maximevlnt/CoolingBrick/Medias/ACDimmerModule.png

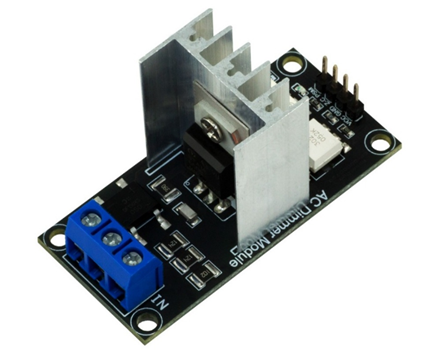
Medias/ACDimmerModule.png
