maximevlnt/CoolingBrick/Medias/CommandTemp.jpg

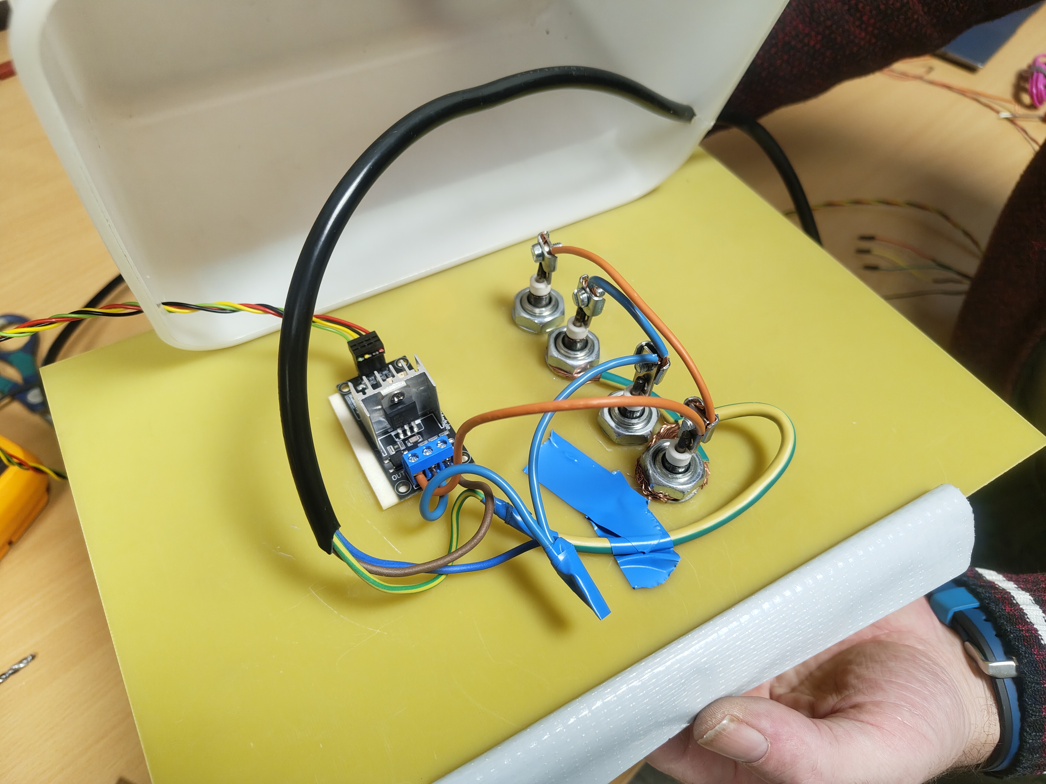
Medias/CommandTemp.jpg
