maximevlnt/CoolingBrick/Medias/CommandVentShema.png

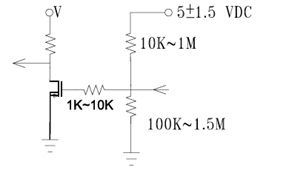
Medias/CommandVentShema.png
