maximevlnt/CoolingBrick/Medias/Dimentionnnement.jpg

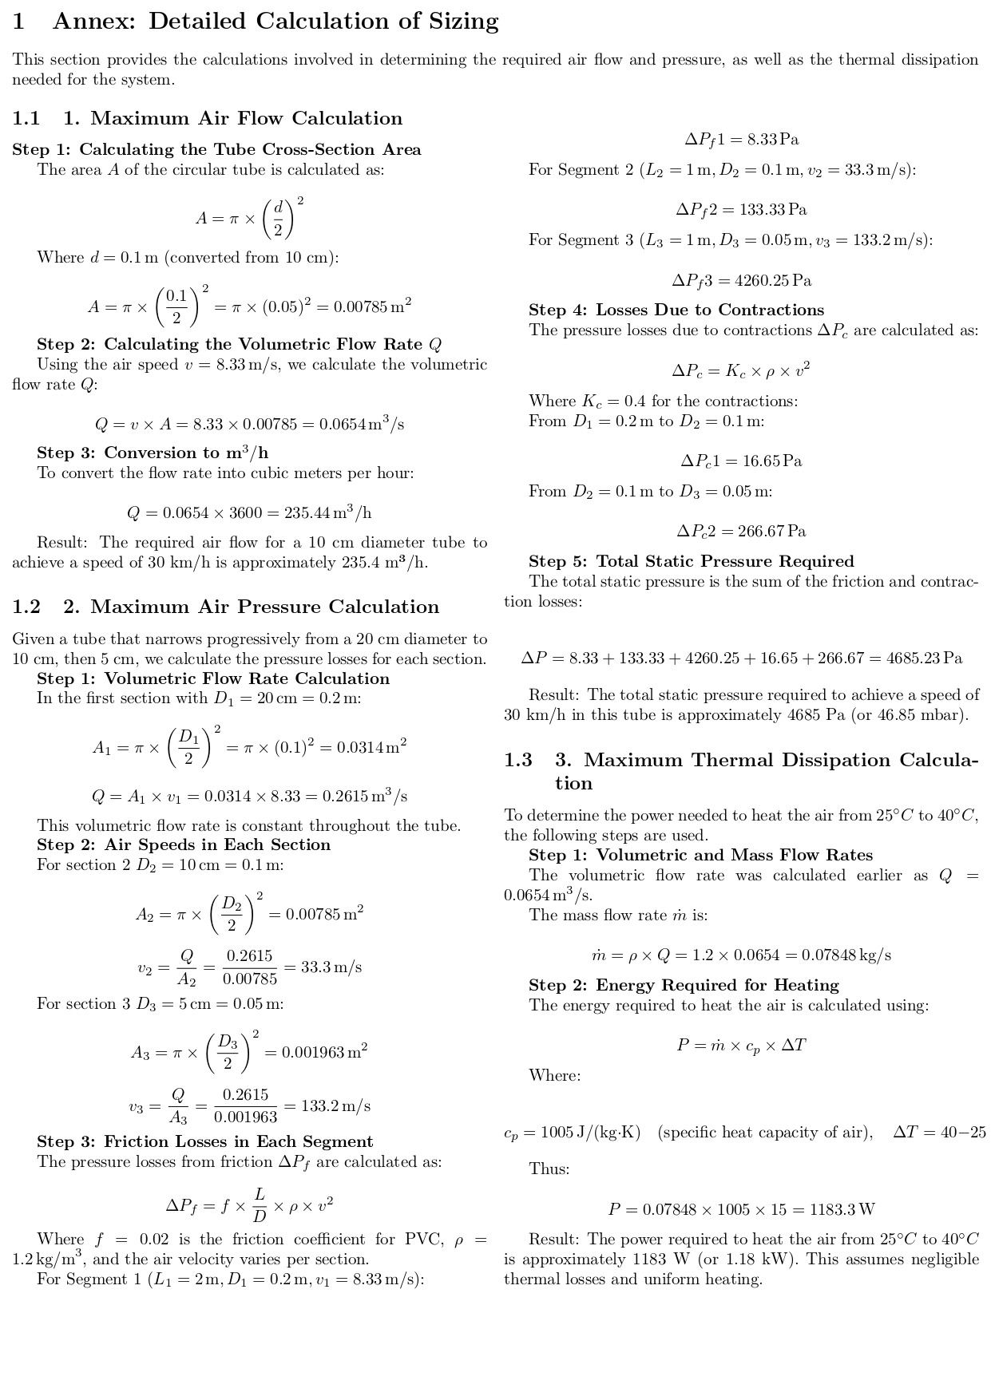
Medias/Dimentionnnement.jpg
