maximevlnt/CoolingBrick/Medias/GanttDiagram.png

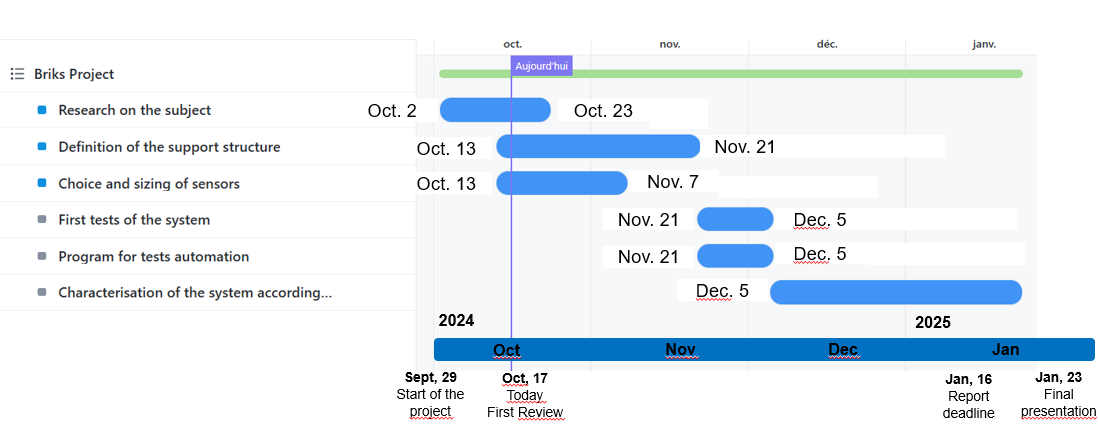
Medias/GanttDiagram.png
