maximevlnt/CoolingBrick/Medias/HeatingResistor.png

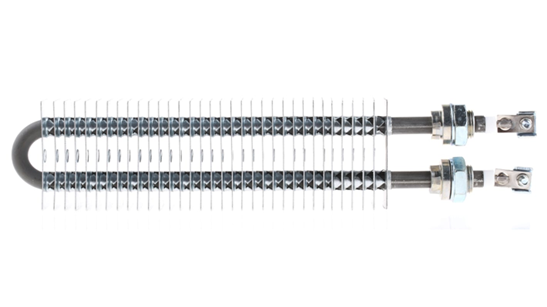
Medias/HeatingResistor.png
