maximevlnt/CoolingBrick/Medias/HumiditySensor.png

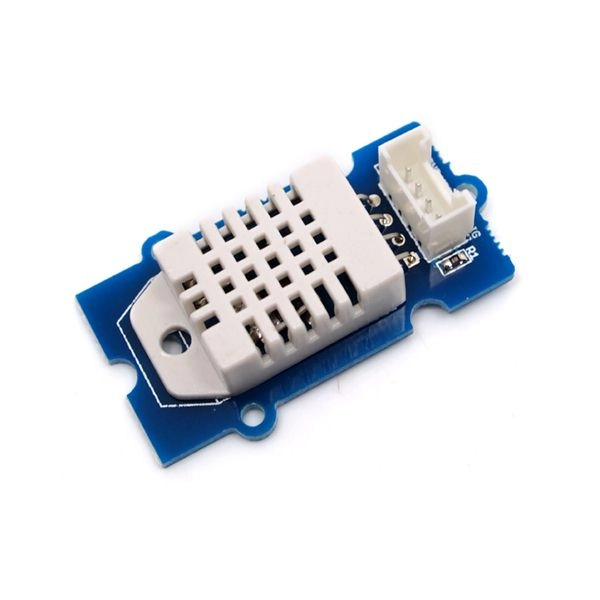
Medias/HumiditySensor.png
