maximevlnt/CoolingBrick/Medias/InstalRes.jpg

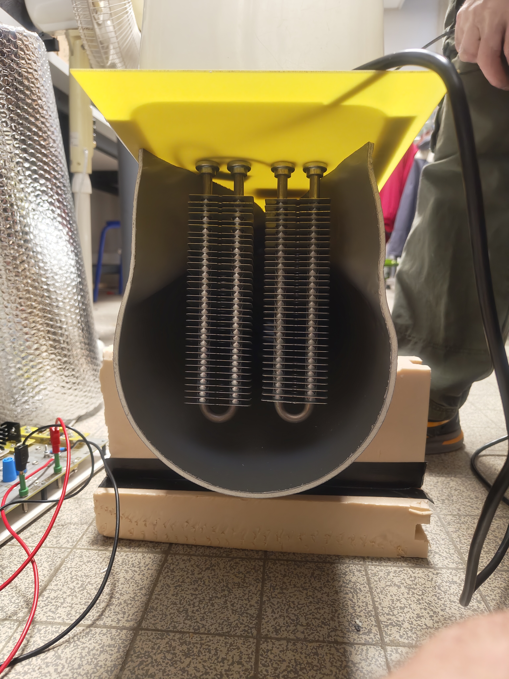
Medias/InstalRes.jpg
