maximevlnt/CoolingBrick/Medias/InstalVent.jpg

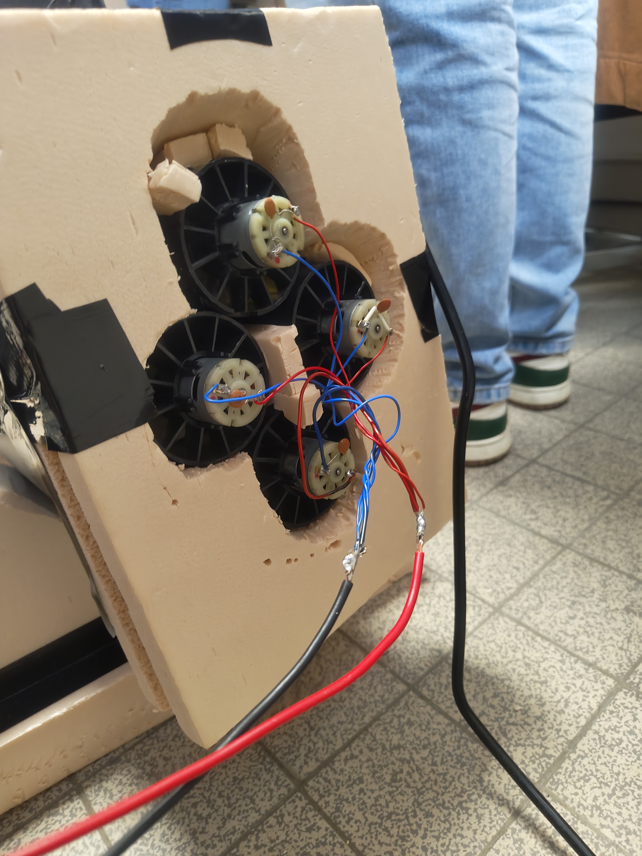
Medias/InstalVent.jpg
