maximevlnt/CoolingBrick/Medias/PressureSensor.png

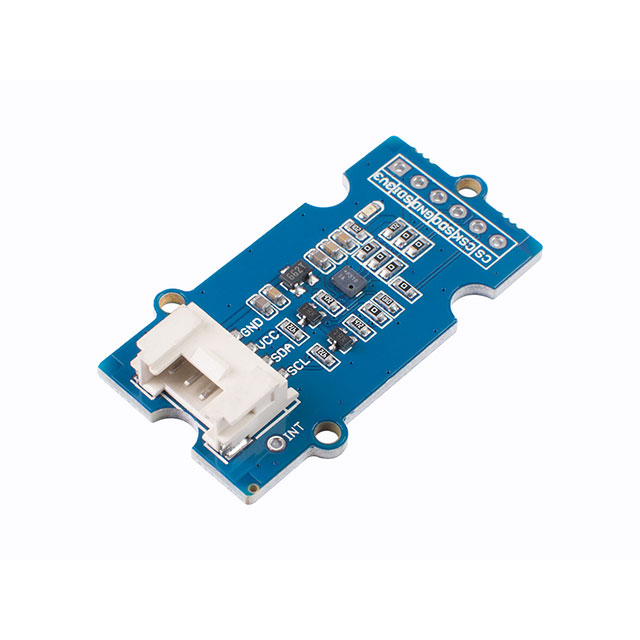
Medias/PressureSensor.png
