maximevlnt/CoolingBrick/Medias/Software1.png

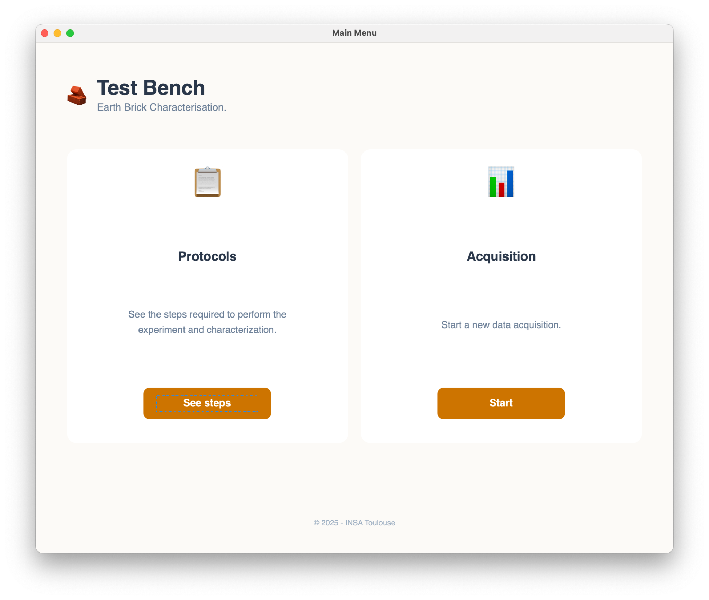
Medias/Software1.png
