maximevlnt/CoolingBrick/Medias/Software2.png

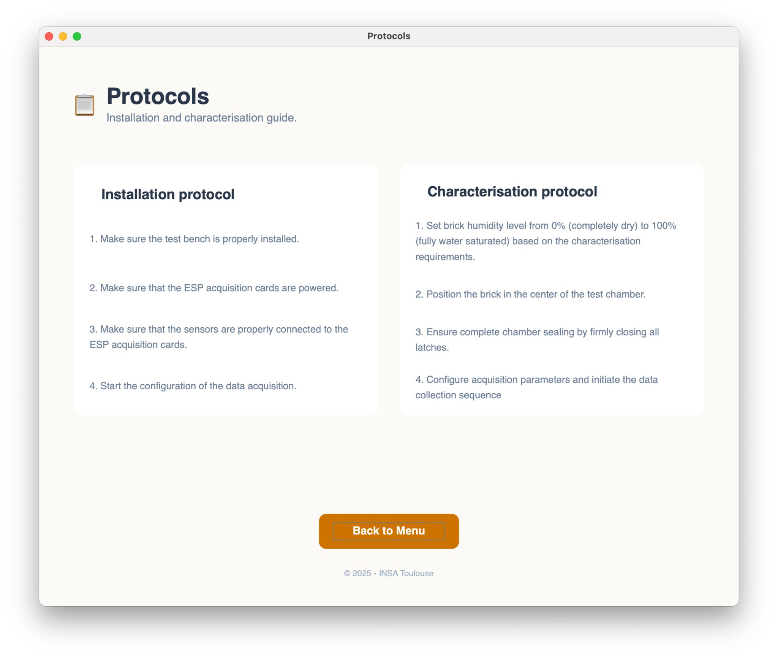
Medias/Software2.png
