maximevlnt/CoolingBrick/Medias/Software3.png

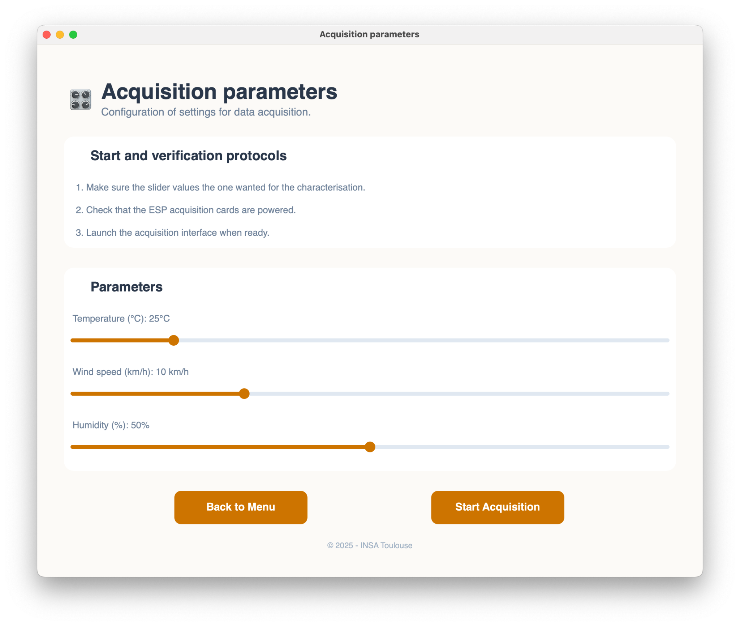
Medias/Software3.png
