maximevlnt/CoolingBrick/Medias/Software5.png

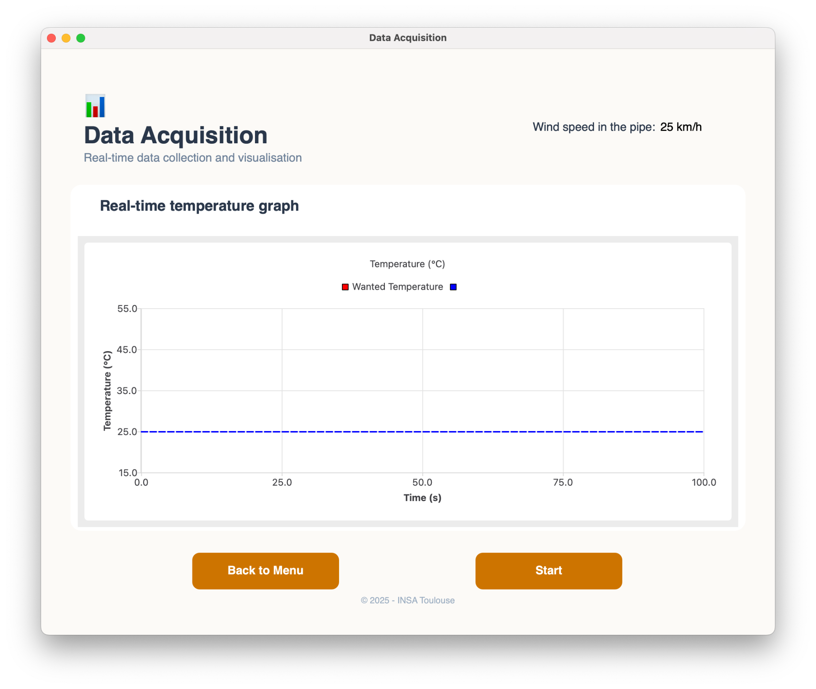
Medias/Software5.png
