maximevlnt/CoolingBrick/Medias/TempSensor.png

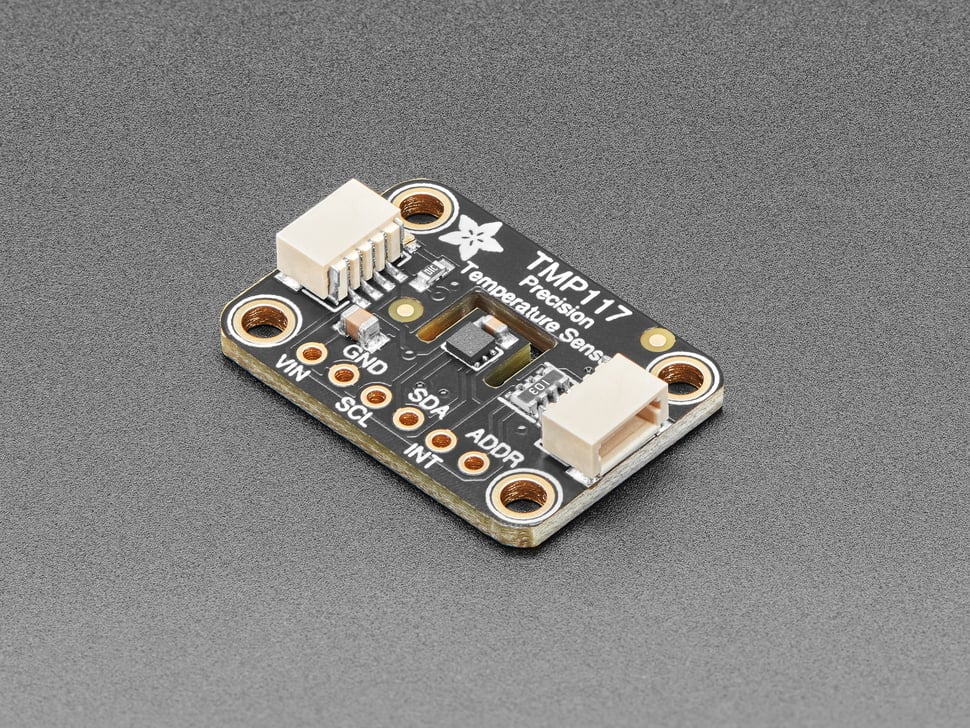
Medias/TempSensor.png
