maximevlnt/CoolingBrick/MaterialsDetails.md

# **Léa Beghin, Nathan Brugière, Alexandre Masson, Hugo Michel, Maxime Valentin**  
## **Innovative Project**  
### **Characterization of Clay Bricks for Air Cooling**  

---

## **Materials Required for Characterization**  

### **Structure and Insulation**  
- **Polystyrene Sheets:** 4 sheets (€2.29 each). **Ref:** 69240556 (LRM)
- **Expanding Foam:** Pack of 3 (€19.90). **Ref:** 88878950  (LRM)
- **80L Plastic Box:** 1 unit (€45.99). **Ref:** 90082298  (LRM)
- **PVC Pipes:**  
  - **200 mm:** 3 m (€19.64/m). **Ref:** 47009 (PUM)  
  - **100 mm:** 1 m (€6.05/m). **Ref:** 47004 (PUM)  
  - **50 mm:** 1 m (€4.00/m). **Ref:** 46999 (PUM)  
- **Reducers:**  
  - **200 mm → 100 mm:** €18.39. **Ref:** 87679197  (LRM)
  - **100 mm → 50 mm:** €5.00. **Ref:** 65827545  (LRM)
- **Water Heater Insulation:** €37.94. **Ref:** 86799955 (LRM)  *Not the one we received*
- **Waterproof Duct Tape:** €13.79. **Ref:** 85868852  (LRM)

### **Sensors and Systems**  
- **2 x Temperature Sensors:** TMP117 (€10.70 each). **Ref:** 485-4821 (Mouser)  
- **2 x Humidity Sensors:** Grove Pro (€10.14 each). **Ref:** 713-101020019 (Mouser)  
- **Pressure Sensor (Pitot Tube):** SEN0360 (€93.70). **Ref:** 426-SEN0360 (Mouser)  
- **2 x High Precision Grove Pressure Sensors:** SEEED Technology (€7.14 each). **Ref:** 1597-101020812-ND (Digikey) → Accuracy +/- 0.2 Pa  
- **Adjustable Fan:** DELTA BCB0812UHN-TP09 (€37.97). **Ref:** 603-1213-ND (Digikey) → Flow rate: 0.854 m³/min  *--underestimated (Better: ref 88911066(LRM))*
- **2 x Heating Element:** Acim Jouanin (€44.01). **Ref:** 374-2296(RS) *--underestimated (Better: 4 x)*
- **AC DIMMER Module 8A** [personal buy on Amazon](https://www.amazon.fr/variateur-lumi%C3%A8re-frequence-logique-compatible/dp/B0B9VF7N4X) (~10€)
- **Current control Experiment Board** Found on TP rooms *--better to build it's own*

## **Estimated Total Cost**  
**~€600 - €700** (depending on final material choices and quantity adjustments)
