maximevlnt/CoolingBrick/Medias/TestbenchShema.png

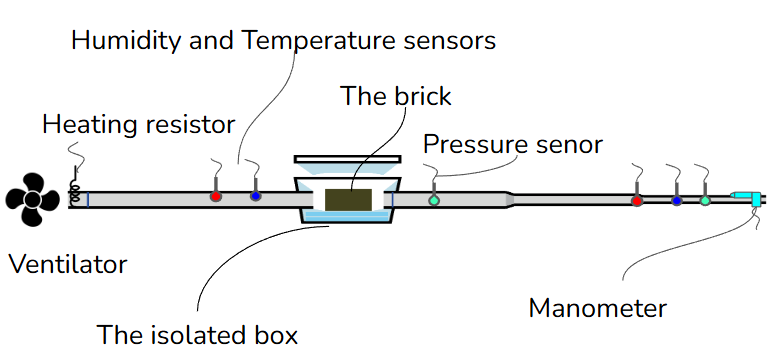
Medias/TestbenchShema.png
