maximevlnt/CoolingBrick/(commit log)

2024-12-14 Update main.py
    Ajout bouton clean.
    Réorganisation de l'interface.
    Amélioration de l'export des données
2025-01-17 commit des nouvelles fonctions
2025-01-18 commit des nouvelles fonctions 2
